dhylands/kicad/Cover.odt

Making Circuit Boards using Kicad

Dave Hylands

dhylands@gmail.com

https://github.com/dhylands/kicad

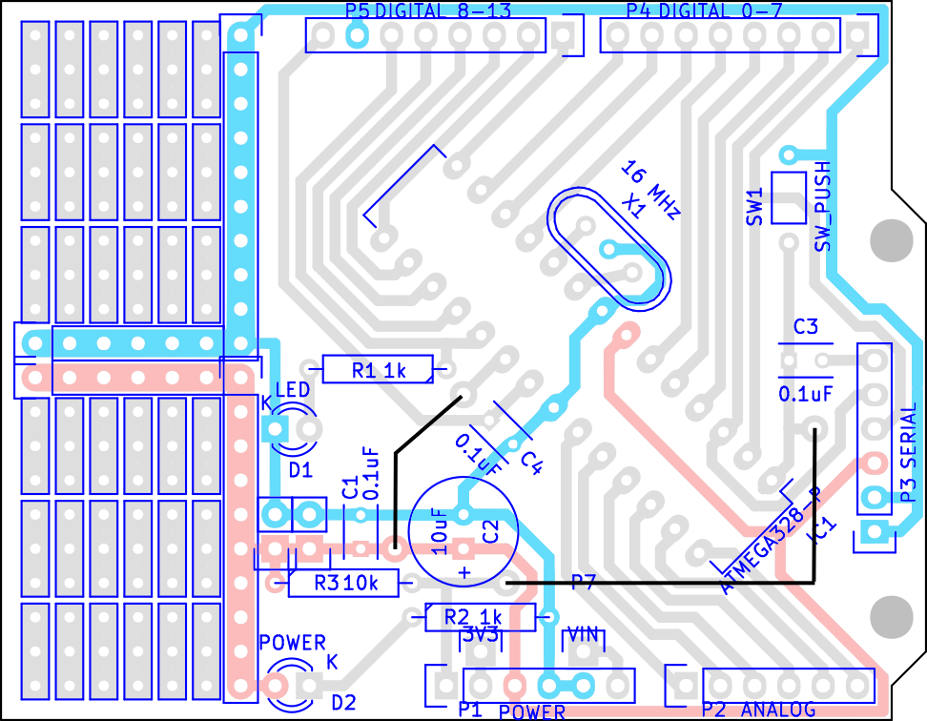
[picture p1: figure]
