dhylands/kicad/Nanino8/nanino8main.png

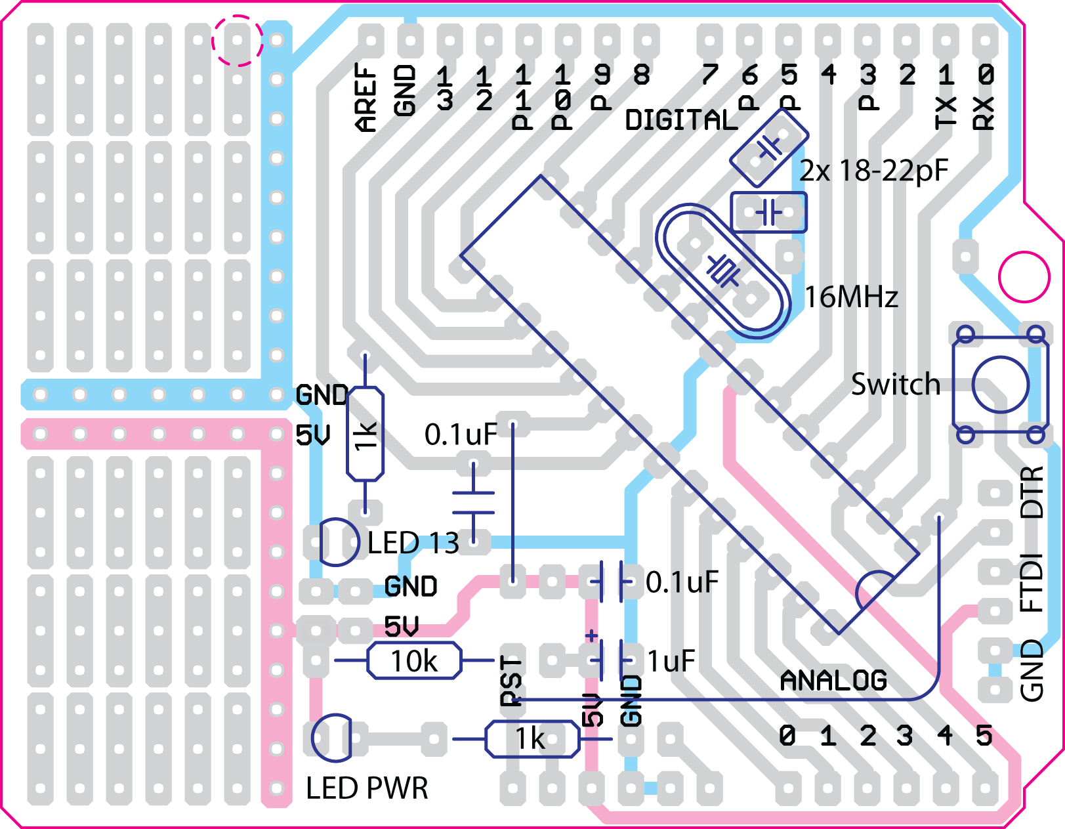
Nanino8/nanino8main.png
