dhylands/kicad/Nanino8/Nanino8-BOM.ods

IC1 | ATMega328 | ATMEGA328-PU-ND | 1 | 3.85 | 25 | 3.85
!C1 | 28-pin DIP socket | ED3050-5-ND | 1 | 0.448 | 10 | 0.45
R1, R2 | 1k ohm | CF18JT1K00CT-ND | 2 | 0.0412 | 50 | 0.08
R3 | 10k ohm | CF18JT10K0CT-ND | 1 | 0.0412 | 50 | 0.04
C1, C3 | 0.1 uF | 399-9776-ND | 2 | 0.2004 | 50 | 0.40
C2 | 10 uF | 493-13406-ND | 1 | 0.1648 | 25 | 0.16
X1 | 16 Mhz resonator | X908-ND | 1 | 0.853 | 10 | 0.85
D1 | Green LED | 1125-1186-ND | 1 | 0.2492 | 25 | 0.25
D2 | Red :LED | 1125-1182-ND | 1 | 0.2292 | 25 | 0.23
SW1 | SPST Pushbutton | 450-1665-ND | 1 | 0.3936 | 25 | 0.39
P1, P2, P3 | 6z1 header | 450-1665-ND | 3 | 0.5727 | 100 | 1.72
P4, P5 | 8x1 header | S7006-ND | 2 | 0.8 | 50 | 1.60
 | PCB
 |  |  |  |  |  | 10.03
