dhylands/kicad/Course.pdf

# Making Circuit Boards using Kicad

## Dave Hylands

dhylands@gmail.com

https://github.com/dhylands/kicad

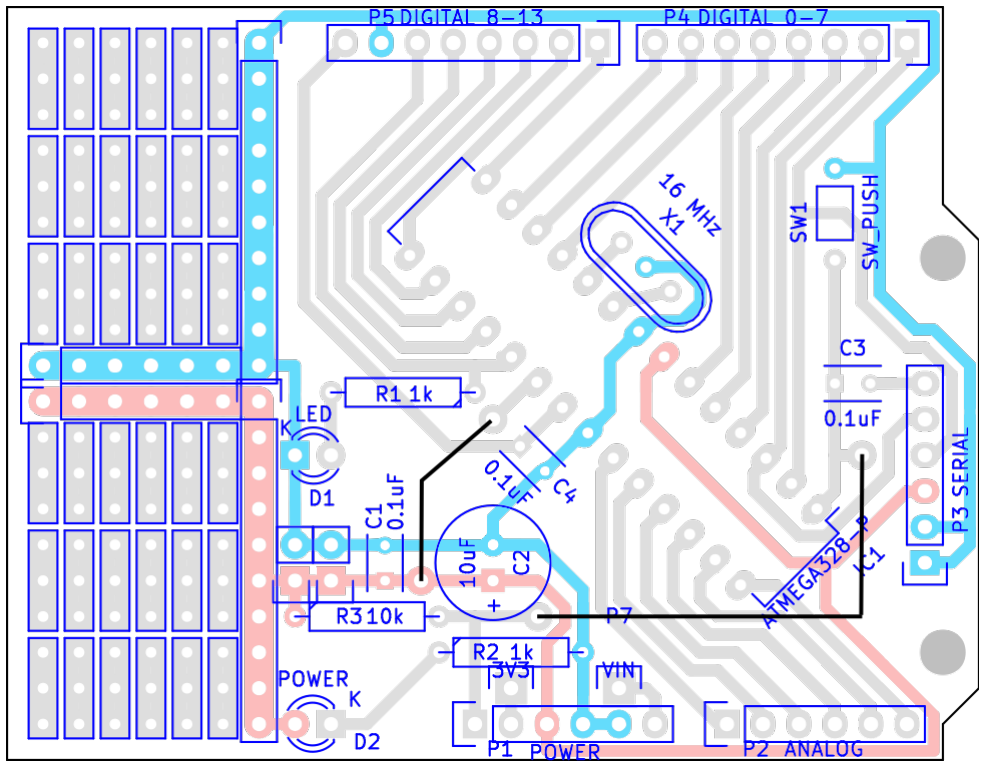
[picture p3: figure]
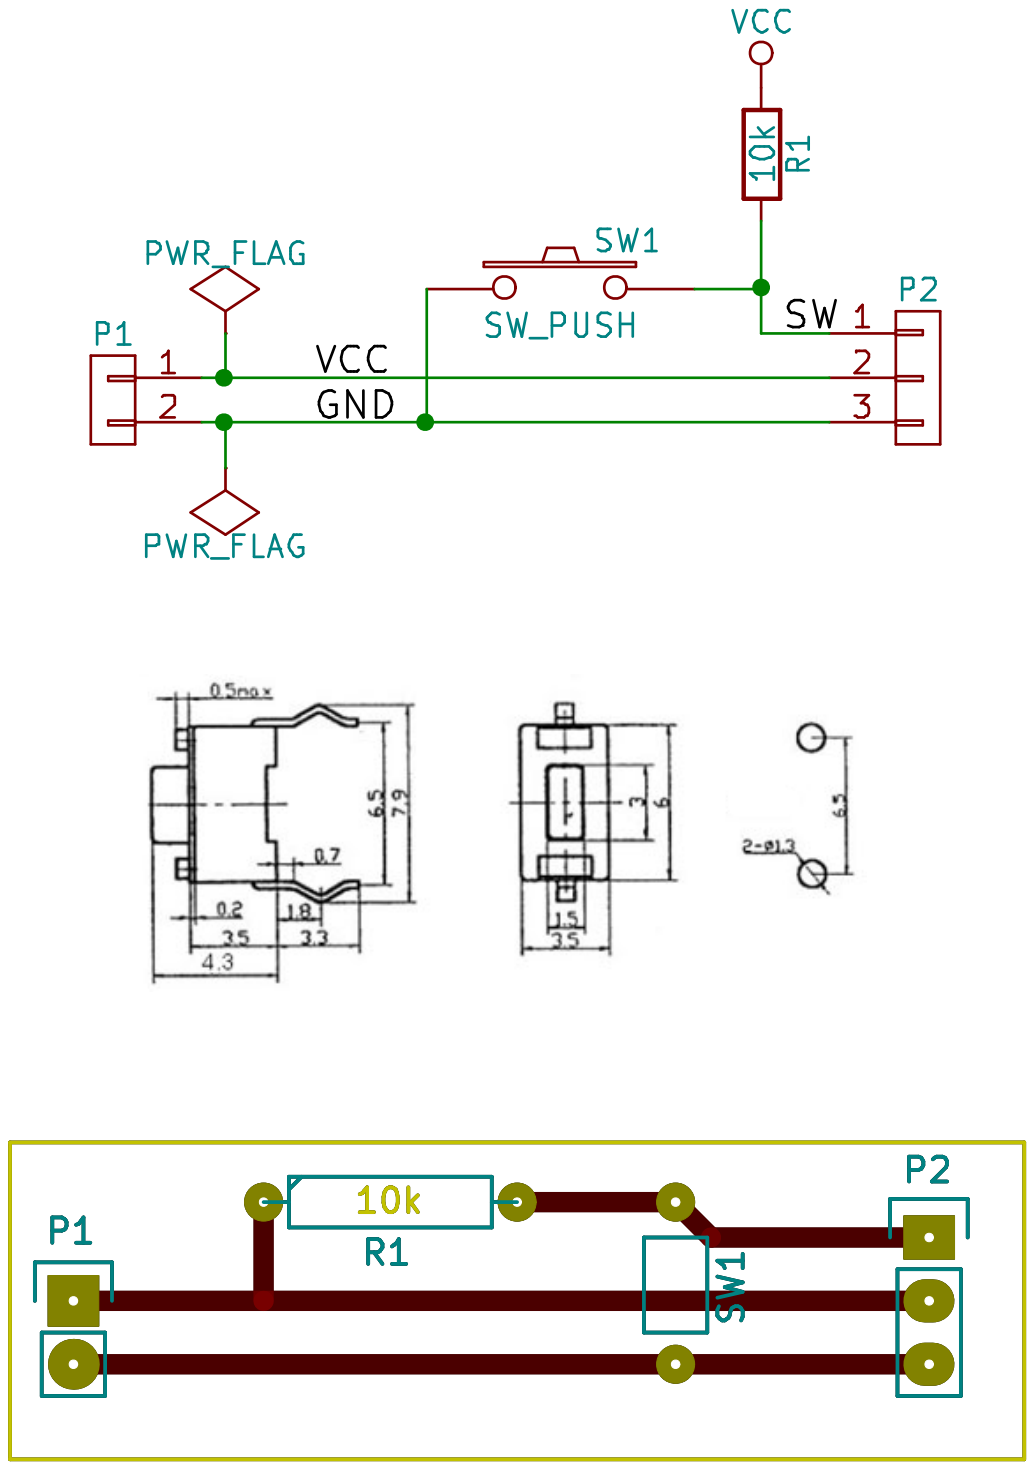
[picture p4: page 2]

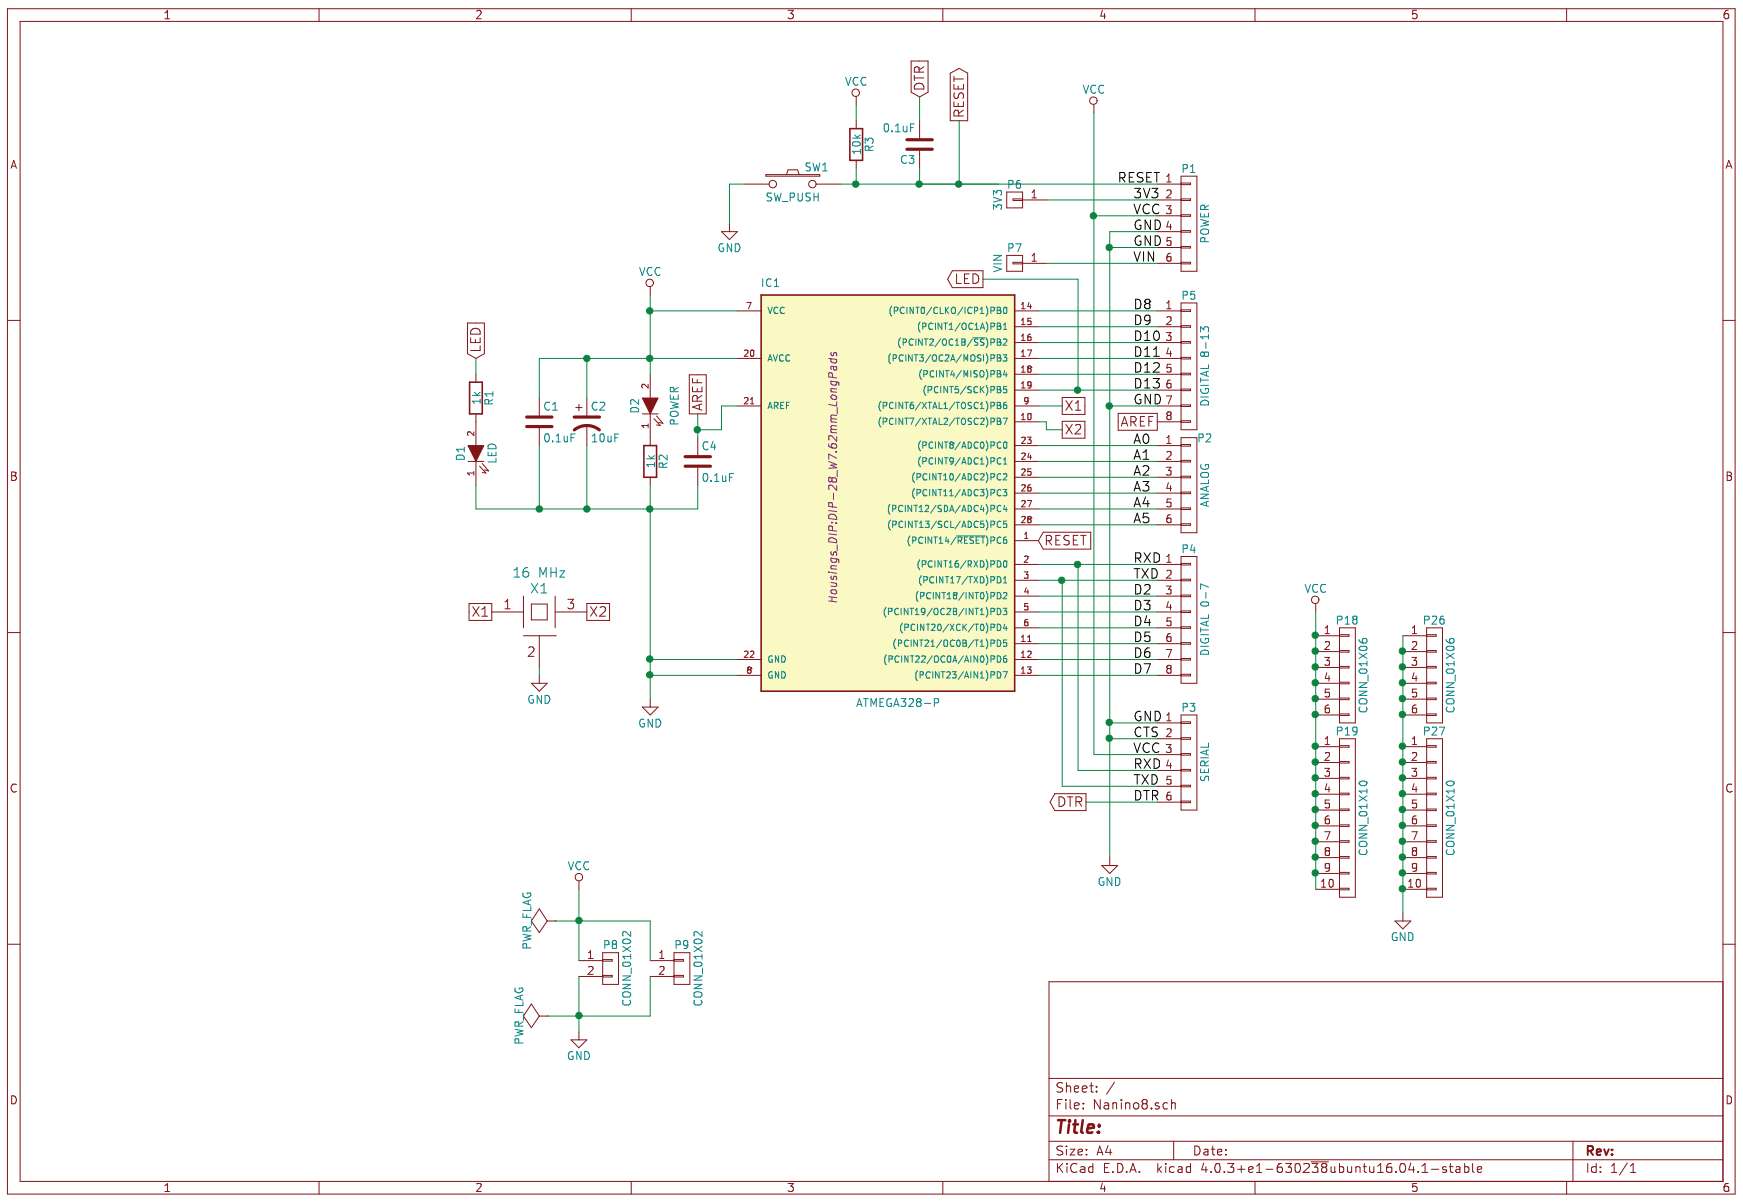
[picture p5: page 3]

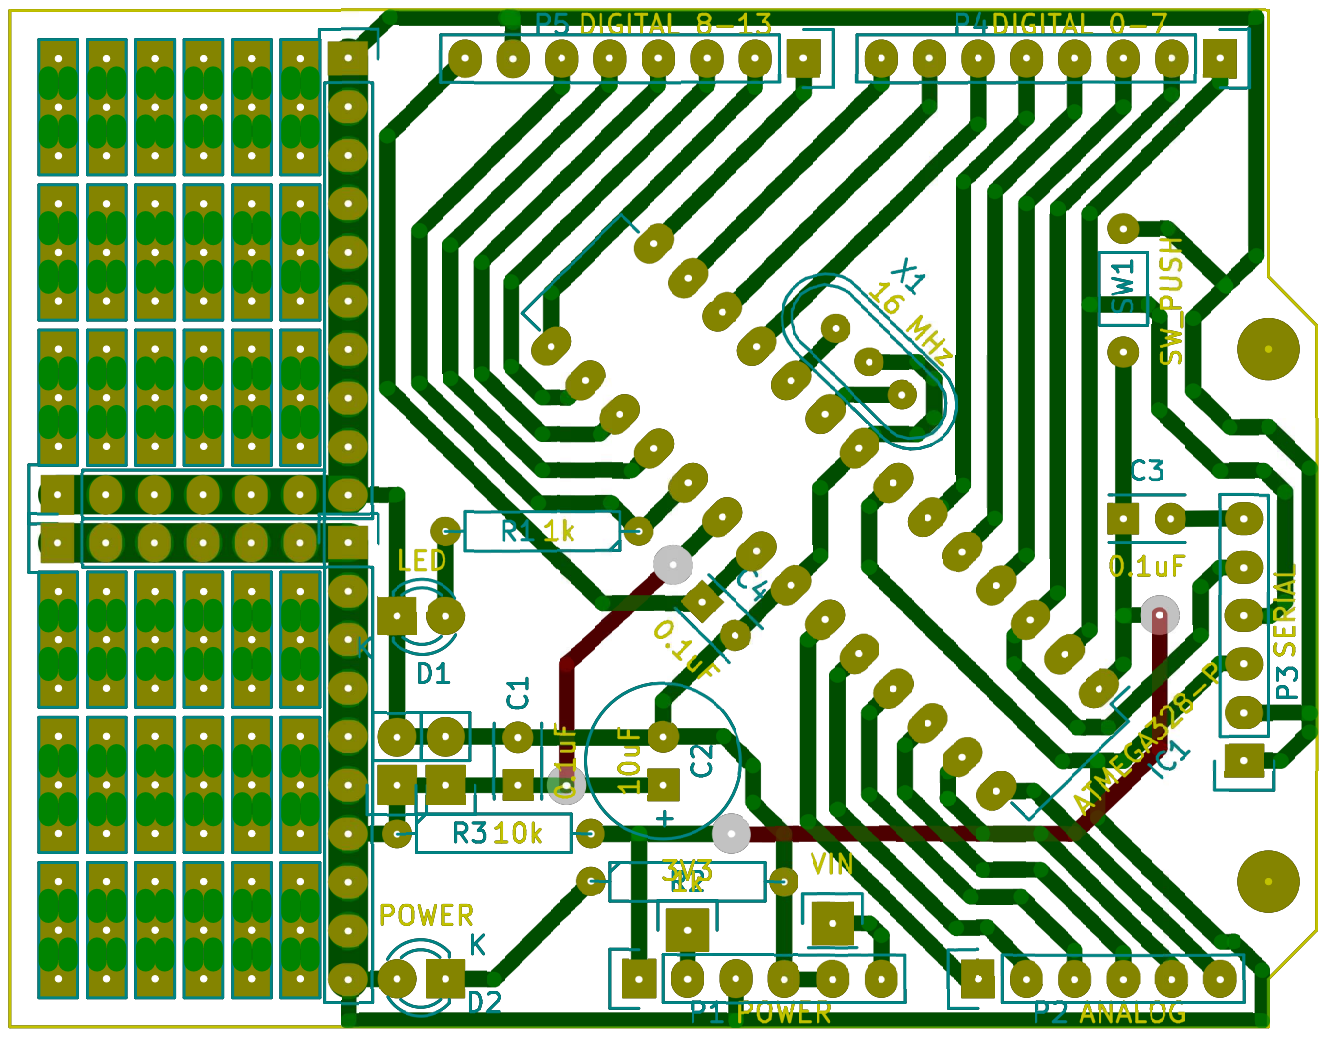
[picture p6: page 4]
