dhylands/kicad/Nanino8-2/Nanino8-2.kicad_pcb

## KiCad design Nanino8-2/Nanino8-2.kicad_pcb (2016-08-28)

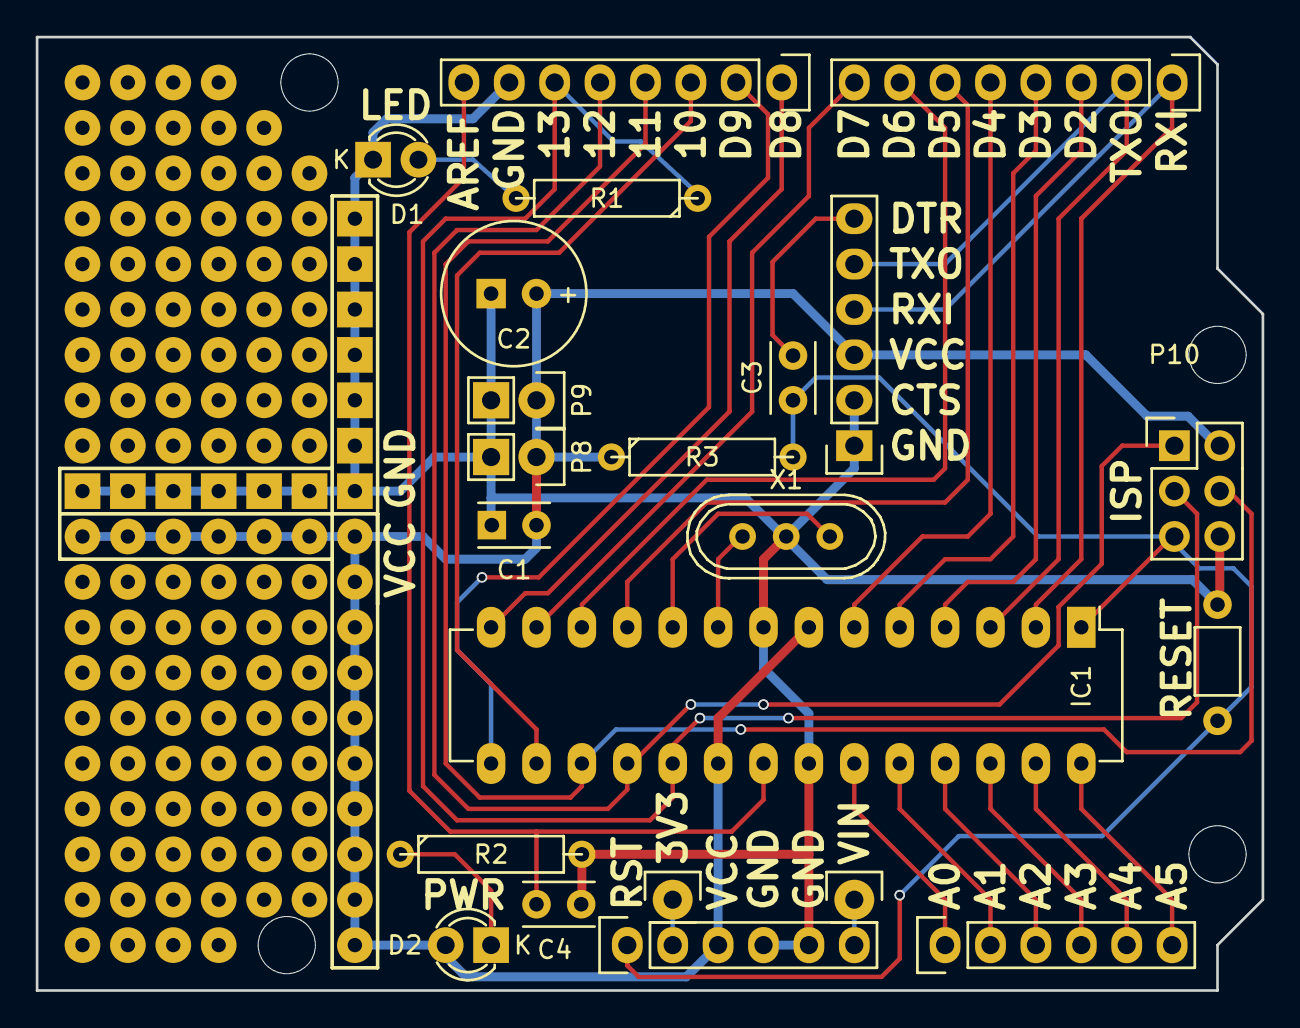
[picture p7: board Nanino8-2.kicad_pcb from above]

Board: 2 copper layers, 68.6 x 53.3 mm, 23 parts (0 on the bottom side), 31 nets.

Parts:
C1, C3, C4: 0.1uF; C_Rect_L4_W2.5_P2.5_Mill
C2: 10uF; C1V8
D1: LED; LED-3MM
D2: POWER; LED-3MM
IC1: ATMEGA328-P; DIP-28_W7.62mm_LongPads
P1: POWER; Pin_Header_Straight_1x06
P2: ANALOG; Pin_Header_Straight_1x06
P3: SERIAL; Pin_Header_Straight_1x06
P4: DIGITAL 0-7; Pin_Header_Straight_1x08
P5: DIGITAL 8-13; Pin_Header_Straight_1x08
P6: 3V3; Pin_Header_Straight_1x01
P7: VIN; Pin_Header_Straight_1x01
P8, P9: CONN_01X02; Pin_Header_Straight_1x02
P10: ISP; Pin_Header_Straight_2x03
R1, R2: 1k; R4
R3: 10k; R4
SW1: SW_PUSH; SW_PUSH-2pin-6.5mm
X1: 16 MHz; Resonator
xREF**: SolderWirePad_single_0-8mmDrill

Connections:
/3V3: P1.2, P6.1
/A0: IC1.23, P2.1
/A1: IC1.24, P2.2
/A2: IC1.25, P2.3
/A3: IC1.26, P2.4
/A4: IC1.27, P2.5
/A5: IC1.28, P2.6
/D2: IC1.4, P4.3
/D3: IC1.5, P4.4
/D4: IC1.6, P4.5
/D5: IC1.11, P4.6
/D6: IC1.12, P4.7
/D7: IC1.13, P4.8
/D8: IC1.14, P5.1
/D9: IC1.15, P5.2
/D10: IC1.16, P5.3
/RXD: IC1.2, P3.4, P4.1
/TXD: IC1.3, P3.5, P4.2
/VIN: P1.6, P7.1
AREF: C4.1, IC1.21, P5.8
DTR: C3.2, P3.6
GND: C1.2, C2.2, C4.2, D1.1, IC1.8, IC1.22, P1.4, P1.5, P3.1, P3.2, P5.7, P8.2, P9.2, P10.6, R2.2, SW1.1, X1.2, xREF**.1
LED: IC1.19, P5.6, P10.3, R1.1
MISO: IC1.18, P5.5, P10.1
MOSI: IC1.17, P5.4, P10.4
unnamed: D1.2, R1.2
unnamed: D2.1, R2.1
RESET: C3.1, IC1.1, P1.1, P10.5, R3.2, SW1.2
VCC: C1.1, C2.1, D2.2, IC1.7, IC1.20, P1.3, P3.3, P8.1, P9.1, P10.2, R3.1
X1: IC1.9, X1.1
X2: IC1.10, X1.3
