dhylands/kicad/Test/Test.kicad_pcb

## KiCad design Test/Test.kicad_pcb (2016-08-25)

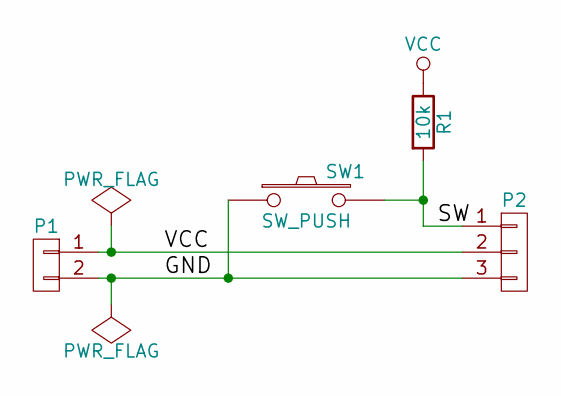
[picture p8: schematic Test.sch]

Parts:
P1: CONN_01X02; Pin_Header_Straight_1x02
P2: CONN_01X03; Pin_Header_Straight_1x03
R1: 10k; R4
SW1: SW_PUSH

Connections:
/GND: P1.2, P2.3, SW1.1
/SW: P2.1, R1.2, SW1.2
VCC: P1.1, P2.2, R1.1

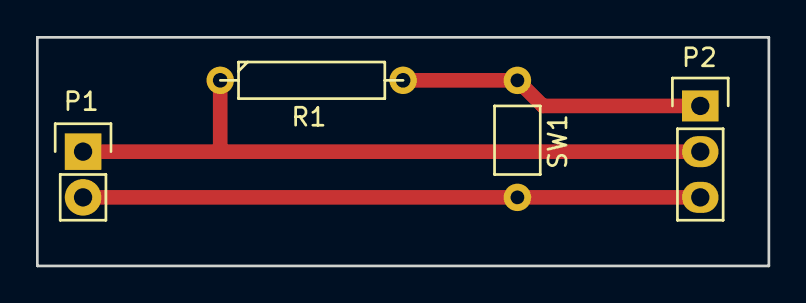
[picture p9: board Test.kicad_pcb from above]

Board: 2 copper layers, 40.6 x 12.7 mm, 4 parts (0 on the bottom side), 3 nets.
