dhylands/kicad/(commit log)

2016-08-08 Initial checkin
    [Nanino8.kicad_pcb, Nanino8.sch, Test.kicad_pcb, Test.sch]
2016-08-08 Added Nanino8 BOM cost
    [Nanino8-BOM.ods]
2016-08-09 Generated gerbers
    [Nanino8.kicad_pcb, Nanino8.sch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]
2016-08-25 Updated for Course Session 1
    [Nanino8-B.Cu.gbr, Nanino8-Edge.Cuts-filled.gbr, Nanino8-Edge.Cuts.gbr, Nanino8-F.Fab.gbr, Nanino8-F.SilkS.gbr, Nanino8-NPTH.drl, Nanino8-X.drl, Nanino8.drl]
2016-08-28 Designed a variation of Nanino8
    This is my backup plan for the PCB course
    just in case the PCB engraving doesn't work.
    [Nanino8-2.kicad_pcb, Nanino8-2.sch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]
2016-08-29 Added rename-gerbers.py script for DirtyPCBs.
2016-09-16 Relocted origin
    [Nanino8-B.Cu.gbl, Nanino8-Edge.Cuts-filled.gm1, Nanino8-Edge.Cuts.gm1, Nanino8-F.SilkS.gto, Nanino8-NPTH.drl, Nanino8.drl]
